arkeks/audio_compressing_fpga/drawings/пп разрез.PNG

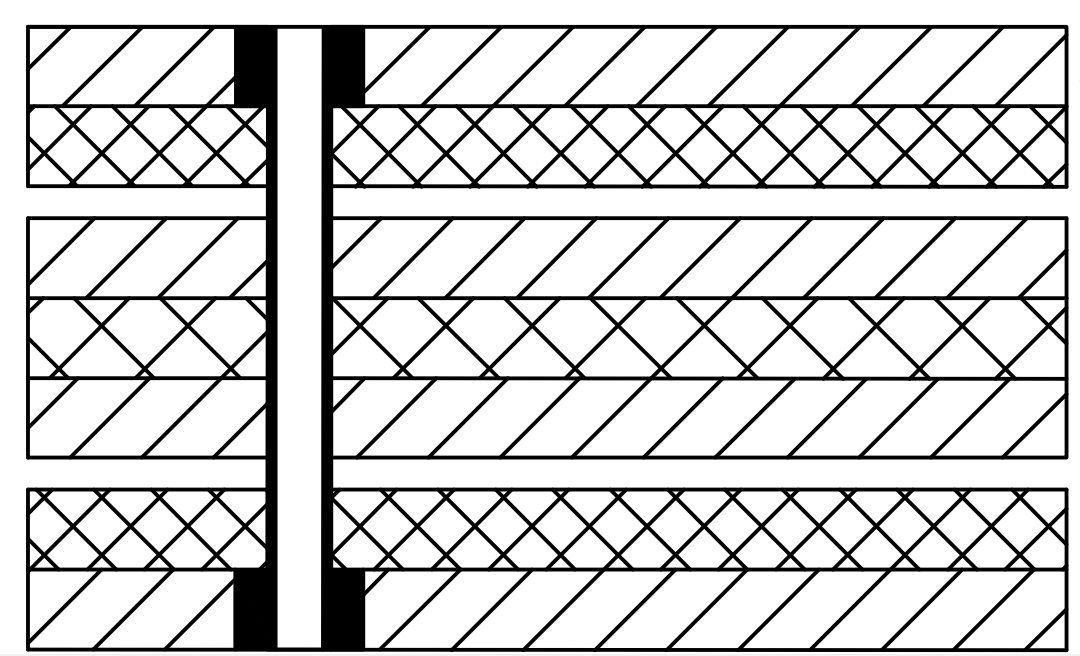
drawings/пп разрез.PNG
