arkeks/audio_compressing_fpga/drawings/табл слои.PNG

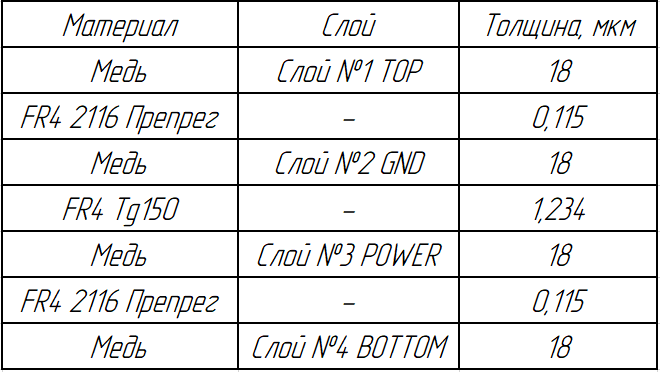
drawings/табл слои.PNG
