arkeks/audio_compressing_fpga/drawings/ПЭ3.xlsx

Поз.обозначение | Наименование | Кол. | Примечание
 | Конденсаторы
C1 | GRM31CR61E476ME44L 47 мкФ 16 В X5R (Murata) | 1
C2 | CL10A475KP8NNNC 4.7 мкФ 10 В X5R (Samsung) | 1
C3-C5 | CL10A106KQ8NNNC 10 мкФ 6.3 В X5R (Samsung) | 3
C6-C8 | GRM21BR60J476ME15L 47 мкФ 6.3 В X5R (Murata) | 3
C9 | GRM31CR60J107ME39L 100 мкФ 6.3 В X5R (Murata) | 1
C10-C14 | GRM21BR60J476ME15L 47 мкФ 6.3 В X5R (Murata) | 5
C15 | CC0603KRX7R9BB104 0.1 мкф 50 В X7R (Yageo) | 1
C16 | CL10A106KQ8NNNC 10 мкФ 6.3 В X5R (Samsung) | 1
C17 | CL10A475KP8NNNC 4.7 мкФ 10 В X5R (Samsung) | 1
C18 | CC0603KRX7R6BB474 0.47 мкФ 10 В X7R (Yageo) | 1
C19-C32 | CL10A475KP8NNNC 4.7 мкФ 10 В X5R (Samsung) | 14
C33 | CC0603KRX7R9BB104 0.1 мкф 50 В X7R (Yageo) | 1
C34-C55 | CC0603KRX7R6BB474 0.47 мкФ 10 В X7R (Yageo) | 22
C56 | CC0603KRX7R9BB104 0.1 мкф 50 В X7R (Yageo) | 1
C57-C60 | CL10A475KP8NNNC 4.7 мкФ 10 В X5R (Samsung) | 4
C61 | CC0603KRX7R9BB104 0.1 мкф 50 В X7R (Yageo) | 1
C62-C65 | CL21C270JBANNNC 27 пФ 50 В X5R (Samsung) | 4
C66, C67 | GRM21BR60J476ME15L 47 мкФ 6.3 В X5R (Murata) | 2
C68 | CC0603KRX7R9BB104 0.1 мкф 50 В X7R (Yageo) | 1
C69 | CL21C270JBANNNC 27 пФ 50 В X5R (Samsung) | 1
C70, C71 | CC0603KRX7R9BB104 0.1 мкф 50 В X7R (Yageo) | 2
C72 | CL10A475KP8NNNC 4.7 мкФ 10 В X5R (Samsung) | 1
C73 | CC0603KRX7R9BB104 0.1 мкф 50 В X7R (Yageo) | 1
C74, C75 | CC0603KRNPO9BN330 33 пФ 50 В X7R (Yageo) | 2
C76-C80 | CC0603KRX7R9BB104 0.1 мкф 50 В X7R (Yageo) | 5
 | Конденсаторы
C81, C82 | CL10A106KQ8NNNC 10 мкФ 6.3 В X5R (Samsung) | 2
C83-C91 | CC0603KRX7R9BB104 0.1 мкф 50 В X7R (Yageo) | 9
C92 | CL10B103KB8NNND 0.01 мкф 50 В X5R (Samsung) | 1
C93-C95 | CC0603KRX7R9BB104 0.1 мкф 50 В X7R (Yageo) | 3
C96, C97 | CC0805KKX5R5BB226 22 мкФ 6.3 В X7R (Yageo) | 2
C98 | CL10A106KQ8NNNC 10 мкФ 6.3 В X5R (Samsung) | 1
C99 | GR442QR73D102KW01L 1000 пФ 2 кВ X5R (Murata) | 1
C100, C101 | CL10B103KB8NNND 0.01 мкф 50 В X5R (Samsung) | 2
 | Микросхемы аналоговые
DA1 | Импульсный регулятор MP2315GJ (Monolithic) | 1
DA2-DA5 | Импульсный регулятор NCP1529 (ONSemi) | 4
DA6 | Импульсный регулятор MP2315GJ (Monolithic) | 1
DA7 | Цифровой микрофон SPH0645LM4H (Knowles) | 1
DA8 | Трансформаторная сборка HX5008NLT (Pulse Electronics) | 1
 | Микросхемы цифровые
DD1 | ПЛИС XC7A35T-1FTG256C (Xilinx) | 1
DD2 | Флеш-память MX25L12835F (Macronix) | 1
DD3 | Кварцевый генератор SG-8018CA TJHPA (Epson) | 1
DD4 | Приёмопередатчик физического уровня Ethernet KSZ9131RXNI (TI) | 1
 | Индуктивности
L1-L6 | VLS6045EX-4R7M-H 4.7 мкГн (TDK) | 6
L7-L11 | MMZ1608Y221BT 220 Ом, 100 МГц (TDK) | 5
 | Резисторы
R1, R2 | RC0805FR-075K1L 5.1 кОм 5% 0.125 Вт (Yageo) | 2
 | Резисторы
R3 | RC0805FR-07120KL 120 кОм 1% 0.125 Вт (Yageo) | 1
R4, R5 | RC0603FR-07220KL 220 кОм 5% 0.125 Вт (Yageo) | 2
R6, R7 | RC0805FR-07120KL 120 кОм 1% 0.125 Вт (Yageo) | 2
R8 | RC0805JR-0720RL 20 Ом 5% 0.125 Вт (Yageo) | 1
R9 | RC0603FR-0720KL 20 кОм 5% 0.125 Вт (Yageo) | 1
R10 | RC0805FR-0768KL 68 кОм 5% 0.125 Вт (Yageo) | 1
R11 | RC0805JR-0720RL 20 Ом 5% 0.125 Вт (Yageo) | 1
R12 | RC0805FR-0768KL 68 кОм 5% 0.125 Вт (Yageo) | 1
R13 | RC0805FR-0733KL 33 кОм 5% 0.125 Вт (Yageo) | 1
R14 | RC0805FR-07120KL 120 кОм 1% 0.125 Вт (Yageo) | 1
R15 | RC0603FR-07180KL 180 кОм 1% 0.125 Вт (Yageo) | 1
R16 | RC0805FR-07360KL 360 кОм 1% 0.125 Вт (Yageo) | 1
R17 | RC0603FR-07180KL 180 кОм 1% 0.125 Вт (Yageo) | 1
R18 | RC0805FR-07560KL 560 кОм 1% 0.125 Вт (Yageo) | 1
R19 | RC0603FR-07180KL 180 кОм 1% 0.125 Вт (Yageo) | 1
R20, R21 | RC0805FR-07120KL 120 кОм 1% 0.125 Вт (Yageo) | 2
R22 | RC0603FR-0739KL 39 кОм 1% 0.125 Вт (Yageo) | 1
R23 | RC0603FR-077K5L 7.5 кОм 5% 0.125 Вт (Yageo) | 1
R24-R27 | RC0805FR-070RL 0 Ом 5% 0.125 Вт (Yageo) | 4
R28 | RC0603FR-0712K4L 12.4 кОм 5% 0.125 Вт (Yageo) | 1
R29 | RC0603FR-0739KL 39 кОм 1% 0.125 Вт (Yageo) | 1
R30, R31 | RC0805FR-070RL 0 Ом 5% 0.125 Вт (Yageo) | 2
R32-R37 | RC0805FR-07220RL 220 Ом 5% 0.125 Вт (Yageo) | 6
R38 | RS-05K472JT 4.7 кОм 5% 0.125 Вт (Yageo) | 1
R39, R40 | RC0805JR-071KL 1 кОм 5% 0.125 Вт (Yageo) | 2
R41, R42 | RS-05K472JT 4.7 кОм 5% 0.125 Вт (Yageo) | 2
R43-R45 | RC0805FR-0751RL 51 Ом 5% 0.125 Вт (Yageo) | 3
R46 | RC0805JR-071KL 1 кОм 5% 0.125 Вт (Yageo) | 1
 | Резисторы
R47 | RS-05K472JT 4.7 кОм 5% 0.125 Вт (Yageo) | 1
R48-R53 | RC0805JR-0720RL 20 Ом 5% 0.125 Вт (Yageo) | 6
R54, R55 | RC0805JR-071KL 1 кОм 5% 0.125 Вт (Yageo) | 2
R56 | RC0603FR-077K5L 7.5 кОм 5% 0.125 Вт (Yageo) | 1
R57-R62 | RC0805JR-0720RL 20 Ом 5% 0.125 Вт (Yageo) | 6
R63 | RS-05K472JT 4.7 кОм 5% 0.125 Вт (Yageo) | 1
R64-R73 | RC0805JR-071KL 1 кОм 5% 0.125 Вт (Yageo) | 10
R74 | RC0805FR-076K04L 6.04 кОм 1% 0.125 Вт (Bourns) | 1
R75-R79 | RC0805JR-071KL 1 кОм 5% 0.125 Вт (Yageo) | 5
R80, R81 | RC1206JR-0775RL 75 Ом 5% 0.25 Вт (Yageo) | 2
R82 | RC0805FR-07220RL 220 Ом 5% 0.125 Вт (Yageo) | 1
R83, R84 | RC1206JR-0775RL 75 Ом 5% 0.25 Вт (Yageo) | 2
R85 | RC0805FR-07220RL 220 Ом 5% 0.125 Вт (Yageo) | 1
SW1 | Кнопка тактовая IT-1187-160GM-G Switronic) | 1
 | Диоды
VD1, VD2 | Диод Шоттки PMEG3050EP (Nexperia) | 2
VD3-VD8 | Светодиод TO-1608BC-PG (Oasis tech.) | 6
VD9, VD10 | Светодиод TO-1608BC-BF (Oasis tech.) | 2
VD11, VD12 | 1N4148W (Oasis tech.) | 2
 | Разъёмы
X1 | USB Type-C (Китай) | 1
X2 | DC005 5,5x2,1 mm (Китай) | 1
X3 | DC3-14P (Китай) | 1
X4 | DS1021-1X3SF11-B (Connfly) | 1
X5 | RJHSE-5381 (Amphenol) | 1
 | Разъёмы
X6 | DS1021-1X10SF11-B (Connfly) | 1
Z1 | Резонатор кварцевый WTL9S85401FO 25 МГц (WTL) | 1
