arkeks/audio_compressing_fpga/(list of files, cad)

Other CAD files:
drawings/acf_pcb_asmb.dwg
drawings/основание_чертёж.dwg
drawings/крышка_чертёж.dwg
