arkeks/audio_compressing_fpga/acf_pcb/Docs/Э3.pdf

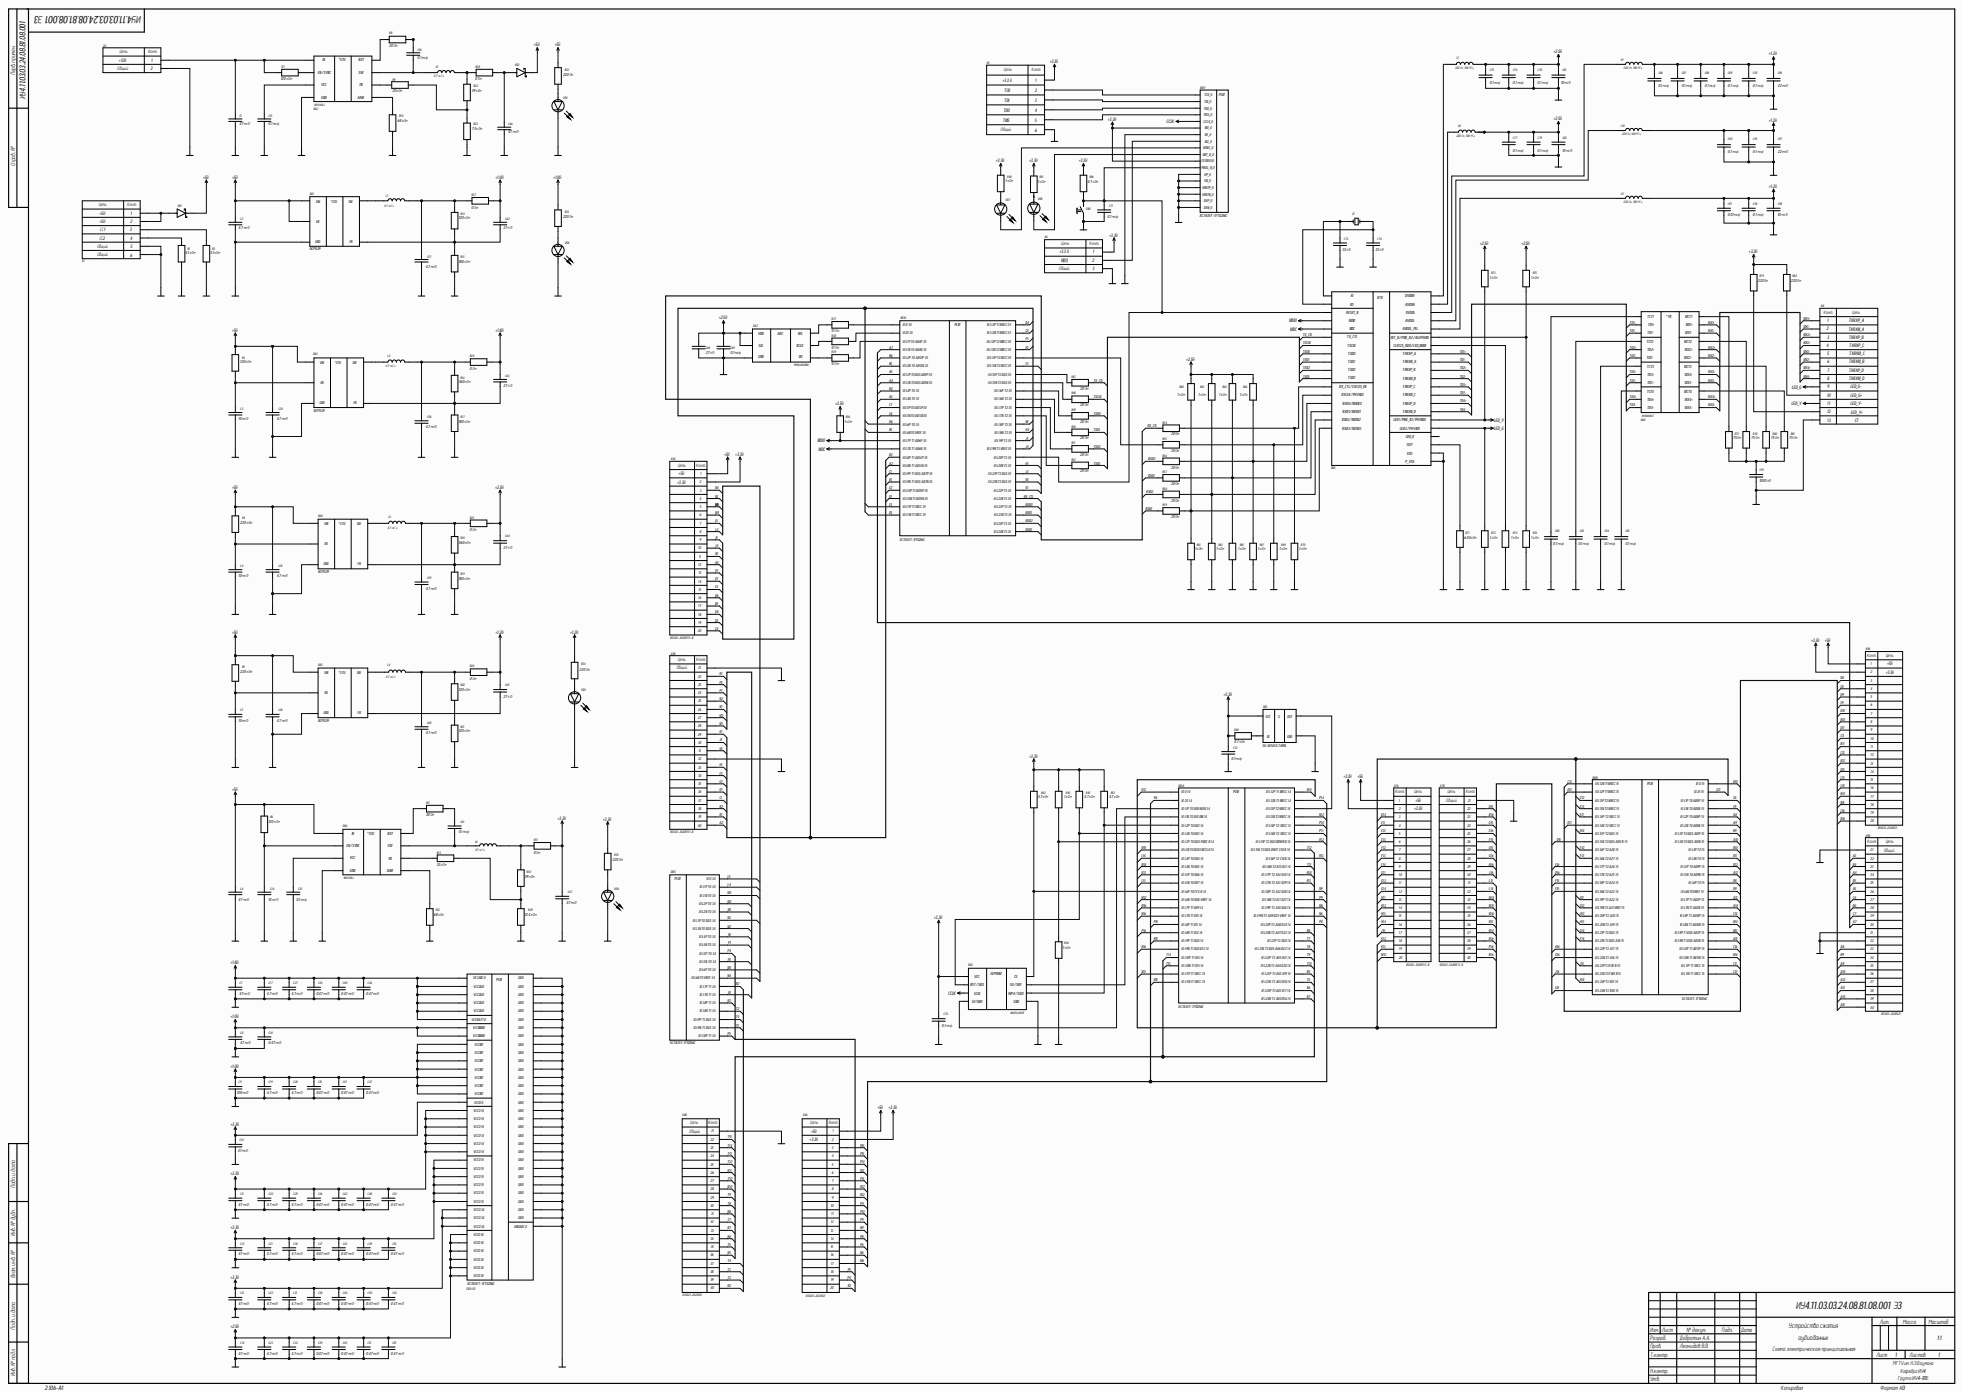
[picture p3: page 1]

Инв. № подл. Инв. № дубл. Подп. и дата Взам. инв. № Подп.и дата Перв.примен. Справ. №

TDO TMS

О бщий | 56 | +3.3В CCLK

RXD0/MODE0 RXD1/MODE1 RXD2/MODE2 RXD3/MODE3 TX_CTL TXCLK RX_CTL/CLK125_EN RXCLK/PHYAD2 XI XO

LDO_O ISET AVDDH AVDDL AVDDL_PLL DVDDH DVDDL P_VSS VSS

IO L13P T2MRCC35 IO L14N T2 SRCC35 IO L14P T2 SRCC35 IO L15N T2 DQS 35 IO L15P T2 DQS 35

IO L3N T0 DQS AD5N 35 IO L3P T0 DQS AD5P 35

IO L21N T3 DQS 35 IO L21P T3 DQS 35

IO L10N T1 AD15N 35 IO L10P T1 AD15P 35 IO L11N T1 SRCC35 IO L11P T1 SRCC35

NCP1529 ENGND DA4 | *STU | SW FB

18
1920

DD2 | IO L8N T1 D12 14 IO L9P T1 DQS 14 IO L9N T1 DQS D13 14 IO L10P T1 D14 14 IO L10N T1 D15 14 IO L11P T1 SRCC 14 IO L11N T1 SRCC 14 | IO L20N T3 A07 D23 14 IO L21P T3 DQS 14 IO L21N T3 DQS A06 D22 14 IO L22P T3 A05 D21 14 IO L22N T3 A04 D20 14 IO L23P T3 A03 D19 14 IO L23N T3 A02 D18 14 IO L24P T3 A01 D17 14 IO L24N T3 A00 D16 14 | 17 | | IO L21P T3 DQS 15 | IO L9P T1 DQS AD3P 15

18 | H16G16 | IO L21N T3 DQS A18 15 IO L22P T3 A17 15 IO L22N T3 A16 15 IO L23P T3FOE B 15 IO L23N T3FWE B 15 IO L24P T3 RS1 15 IO L24N T3 RS0 15 | IO L9N T1 DQS AD3N 15 IO L10P T1 AD11P 15 IO L10N T1 AD11N 15 IO L11P T1 SRCC 15 IO L11N T1 SRCC 15

VCCO 0 VCCO 14 VCCO 14 VCCO 14 VCCO 14 VCCO 14 VCCO 14 VCCO 15 VCCO 15 VCCO 15 VCCO 15 VCCO 15 VCCO 15 VCCO 34 VCCO 34 VCCO 34 VCCO 35 VCCO 35 VCCO 35 VCCO 35 VCCO 35 VCCO 35 VCCINT VCCINT VCCINT VCCINT VCCINT VCCINT VCCINT VCCBRAM VCCBRAM VCCAUX VCCAUX VCCAUX VCCAUX VCCBATT 0 VCCADC 0

Изм | . Л и с т | № д о к у м . | По д п . | Д ата | | | | 1:1

Ус тр о йс т во сжат ия ау ди о данных С х е м а э л е ктр и ч е с к ая п р и н ц и п иаль ная | Л и т . | Мас с а | Масштаб

Н . к о нтр .
Утв .

Т . к о нтр . | Л и с т 1 Л и сто в 1

М Г ТУ и м. Н . Э . Б ау м ана К аф е др а И У4 Гру п п а И У 4-81Б
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
