arkeks/audio_compressing_fpga/(list of files, drawings)

Other design files:
acf_pcb/acf_foot.PcbLib
acf_pcb/acf_pcb.PrjPcb
acf_pcb/acf_sch.SchLib
acf_pcb/acf_schematic.SchDoc
acf_pcb/acf_schematic_gost.SchDoc
acf_pcb/asmb_route.SchDoc
acf_pcb/functional.SchDoc
acf_pcb/measure.SchDoc
acf_pcb/structural.SchDoc
