arkeks/audio_compressing_fpga/(commit log)

2024-02-02 Add components into lib
    [acf_foot.PcbLib, acf_pcb.PrjPcb, acf_sch.SchLib]
2024-02-04 Add phy in lib (KSZ9131)
    [acf_sch.SchLib]
2024-02-06 Minor (init shematic)
    [acf_pcb.PrjPcb, acf_schematic.SchDoc]
2024-02-09 Add capacitors, resistors, inductor for NCP1529; fixed size of NCP1529
    [acf_foot.PcbLib, acf_sch.SchLib]
2024-02-09 Add stabilisation schemes for 1V supplies
    [acf_schematic.SchDoc]
2024-02-11 Add XC7A35T in lib, fixed some parts in lib
    [acf_foot.PcbLib, acf_sch.SchLib]
2024-02-11 Add power part; add config part
    [acf_schematic.SchDoc]
2024-02-12 Add leds
    [acf_foot.PcbLib, acf_sch.SchLib]
2024-02-14 Add 3-pin-header and some resistors
    [acf_foot.PcbLib, acf_sch.SchLib]
2024-02-14 Add remaining connections for config pins and SPI flash boot
    [acf_schematic.SchDoc]
2024-02-18 Add oscillator, 2 kV cap; fixed some symbols
    [acf_foot.PcbLib, acf_sch.SchLib]
2024-02-18 Connected fpga osc; started connecting phy
    [acf_schematic.SchDoc]
2024-02-18 Add more caps, ferrite bead
    [acf_foot.PcbLib, acf_sch.SchLib]
2024-02-18 Add power for PHY
    [acf_schematic.SchDoc]
2024-02-23 Add phy crystal
    [acf_foot.PcbLib, acf_sch.SchLib, acf_schematic.SchDoc]
2024-02-25 Added power connectors, 12V -> 5V converter, power leds
    [acf_foot.PcbLib, acf_sch.SchLib, acf_schematic.SchDoc]
2024-02-26 Added 40 pin header, socket footprints; reworked fpga symbol
    [acf_foot.PcbLib, acf_sch.SchLib]
2024-02-26 Minor schematic changes
    [acf_schematic.SchDoc]
2024-02-29 40 pin headers patch + add to schematic
    [acf_foot.PcbLib, acf_sch.SchLib, acf_schematic.SchDoc]
2024-02-29 Schematic upd
    [acf_foot.PcbLib, acf_sch.SchLib, acf_schematic.SchDoc]
2024-03-03 Removed some dedicated power pins from 40pin headers
    [acf_sch.SchLib]
2024-03-03 Started assigning fpga pins to headers
    [acf_schematic.SchDoc]
2024-03-03 Rework of ethernet part with buses and 2.5mm grid
    [acf_sch.SchLib, acf_schematic.SchDoc]
2024-03-03 Changed header's grid to 2.5mm
    [acf_sch.SchLib]
2024-03-03 Connected 2nd (top) header
    [acf_schematic.SchDoc]
2024-03-06 Added left header connections
    [acf_sch.SchLib, acf_schematic.SchDoc]
2024-03-06 Bottom socket mid commit
    [acf_sch.SchLib, acf_schematic.SchDoc]
2024-03-06 Rework right header bus from 14 bank
    [acf_schematic.SchDoc]
2024-03-06 Made some symbols into 2.5 mm grid
    [acf_sch.SchLib]
2024-03-06 Connected all gpio to headers/sockets; refactored positions on schematic
    [acf_schematic.SchDoc]
2024-03-06 Removed visibility of fpga pins' designators
    [acf_sch.SchLib]
2024-03-06 Add GOST variant of schematic + some fixes
    [acf_schematic.SchDoc, acf_schematic_gost.SchDoc]
2024-03-06 Made annotation
    [acf_schematic.SchDoc, acf_schematic_gost.SchDoc]
2024-03-10 Changed fpga power part to 2.5mm grid
    [acf_pcb.PrjPcb, acf_sch.SchLib, acf_schematic_gost.SchDoc]
2024-03-10 Fixed main inscription
    [acf_schematic_gost.SchDoc]
2024-03-10 Add docs
    [acf_schematic_gost.SchDoc]
2024-03-16 Changed all 0.1uF to 0603
    [acf_schematic_gost.SchDoc]
2024-03-16 Updated 22 uF caps
    [acf_sch.SchLib, acf_schematic_gost.SchDoc]
2024-03-16 Fixed 10 uF caps
    [acf_schematic_gost.SchDoc]
2024-03-16 Updated 33 pF caps
    [acf_sch.SchLib, acf_schematic_gost.SchDoc]
2024-03-16 Updated 47 uF caps
    [acf_sch.SchLib, acf_schematic_gost.SchDoc]
2024-03-17 Changed 120k resistors
    [acf_sch.SchLib, acf_schematic_gost.SchDoc]
2024-03-17 Update 220k res
    [acf_sch.SchLib, acf_schematic_gost.SchDoc]
2024-03-17 Update 180k res
    [acf_sch.SchLib, acf_schematic_gost.SchDoc]
2024-03-17 Update 39k res
    [acf_sch.SchLib, acf_schematic_gost.SchDoc]
2024-03-17 Update 6.04k res
    [acf_sch.SchLib, acf_schematic_gost.SchDoc]
2024-03-17 Update 0.47uF caps
    [acf_sch.SchLib, acf_schematic_gost.SchDoc]
2024-03-28 Caps and resistors upd
    [acf_foot.PcbLib, acf_sch.SchLib]
2024-03-28 PCB initial
2024-03-28 Change 0ohm position
    [acf_schematic_gost.SchDoc]
2024-04-06 Tracing process 1
    [acf_pcb.PrjPcb, acf_sch.SchLib, acf_schematic_gost.SchDoc]
2024-04-06 All DC-DC routed v1
    [acf_schematic_gost.SchDoc]
2024-04-08 Change phy to magnetics and magnetics to rj-45 nets
    [acf_schematic_gost.SchDoc]
2024-04-10 Fixed ferrite beams connections
    [acf_schematic_gost.SchDoc]
2024-04-14 Remade some schematic connections for pcb tracing convenience
    [acf_sch.SchLib, acf_schematic_gost.SchDoc]
2024-04-15 Routed phy to magnetics
    [acf_pcb.PrjPcb]
2024-04-17 Fixed mag to rj45 connection
    [acf_foot.PcbLib, acf_sch.SchLib, acf_schematic_gost.SchDoc]
2024-04-25 Changed reset cheme; added diode into lib
    [acf_foot.PcbLib, acf_sch.SchLib, acf_schematic_gost.SchDoc]
2024-04-26 JTAG, osc, SPI Flash routing
    [acf_foot.PcbLib, acf_sch.SchLib, acf_schematic_gost.SchDoc]
2024-04-28 Replaced pin headers; traced all together; started power tracing; fixes, etc.
    [acf_foot.PcbLib, acf_sch.SchLib, acf_schematic_gost.SchDoc]
2024-04-29 Finished power and ground planes; fixed unconnected nets; pre-release version
2024-05-01 GOST refactor
    [acf_sch.SchLib, acf_schematic_gost.SchDoc]
2024-05-01 Updated caps footprints; updated from schematic
2024-05-01 Added chassis to other layers and stitching
2024-05-02 Remage RX_RMII (PHY) traces
2024-05-03 Add 47uF, 16V cap
    [acf_sch.SchLib]
2024-05-03 Replace C1 with 16V tolerant
    [acf_schematic_gost.SchDoc]
2024-05-03 Replaced C1 cap to 1206 (16V)
2024-05-03 Changed rj-45 leds traces to increase MDI<->signals clearance
2024-05-05 Changed leds locations for lightguides fitting
2024-05-05 Moved power connectors closer to the edge
2024-05-05 Added mounting holes; increased polys' clearance
2024-05-05 Fixed bottom chassis shape
2024-05-05 Changed ground plane
2024-05-05 Add optional caps chassis<->GND; fixed silk objects
    [acf_foot.PcbLib, acf_schematic_gost.SchDoc]
2024-05-06 Rules errors fixes; eth led connection reroute
    [acf_foot.PcbLib]
2024-05-06 Removed mounting holes metallization
2024-05-07 Silk refactor
    [acf_foot.PcbLib]
2024-05-12 BOAS pcb scheme init
2024-05-17 Made pcb drawing
    [acf_schematic_gost.SchDoc]
2024-05-22 Started drawings for 3d models
    [acf_pcb_asmb.dwg, крышка_чертёж.dwg, основание_чертёж.dwg]
2024-05-22 Made variants for soldering
2024-05-22 GOST fixes
    [acf_sch.SchLib, acf_schematic_gost.SchDoc]
2024-06-14 Many GOST and small updates
    [acf_foot.PcbLib, acf_pcb_asmb.dwg, acf_sch.SchLib, acf_schematic_gost.SchDoc, asmb_route.SchDoc, functional.SchDoc, measure.SchDoc, structural.SchDoc]
2024-06-14 BOAS spec
    [ПЭ3.xlsx]
2024-06-14 Text doc + pcb drawing fixes
2024-06-16 Deleted no working LEDs
    [acf_schematic_gost.SchDoc]
